PPKoller/ArgonCubeSlowControl/documents/ArgonCubeSlowControl_top_schematic.png

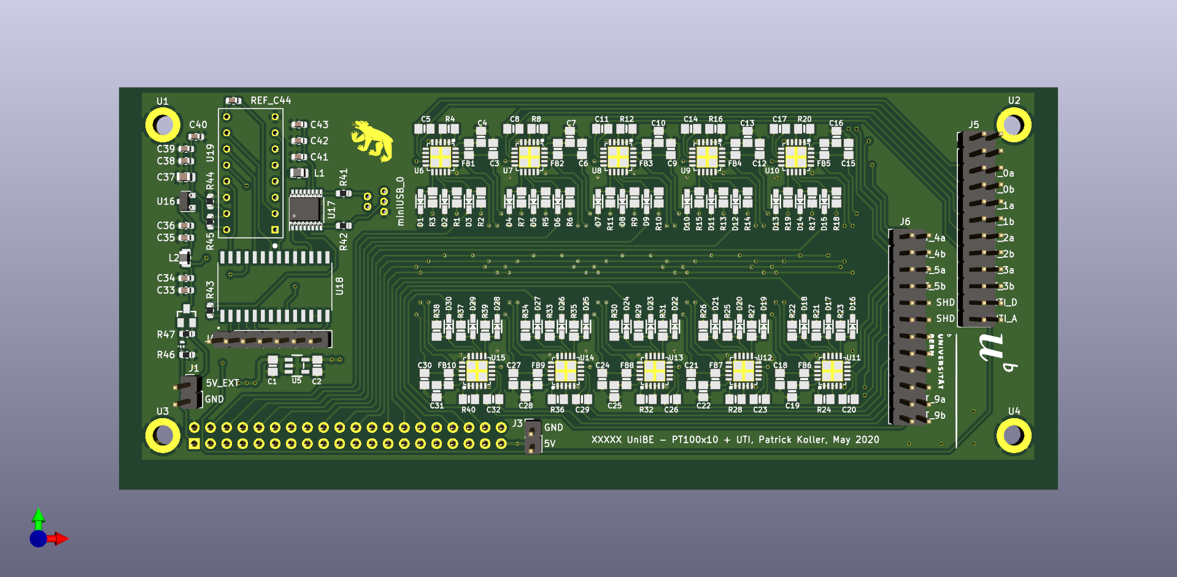
documents/ArgonCubeSlowControl_top_schematic.png
