PPKoller/ArgonCubeSlowControl/README.md

# ArgonCubeSlowControl
ArgonCube slow control PCB board.
