PPKoller/ArgonCubeSlowControl/documents/notes.txt

https://www.digikey.ch/product-detail/de/diodes-incorporated/DMN1150UFB-7B/DMN1150UFB-7BDITR-ND/3986748
https://www.digikey.ch/product-detail/de/on-semiconductor/NVTR0202PLT1G/NVTR0202PLT1GOSDKR-ND/9089349
