PPKoller/ArgonCubeSlowControl/documents/SlowControl_09032020.odp

## ArgonCube SC: PCB Design Front

UTI miniUSB

10x PT-100

UTI for lvl-meter

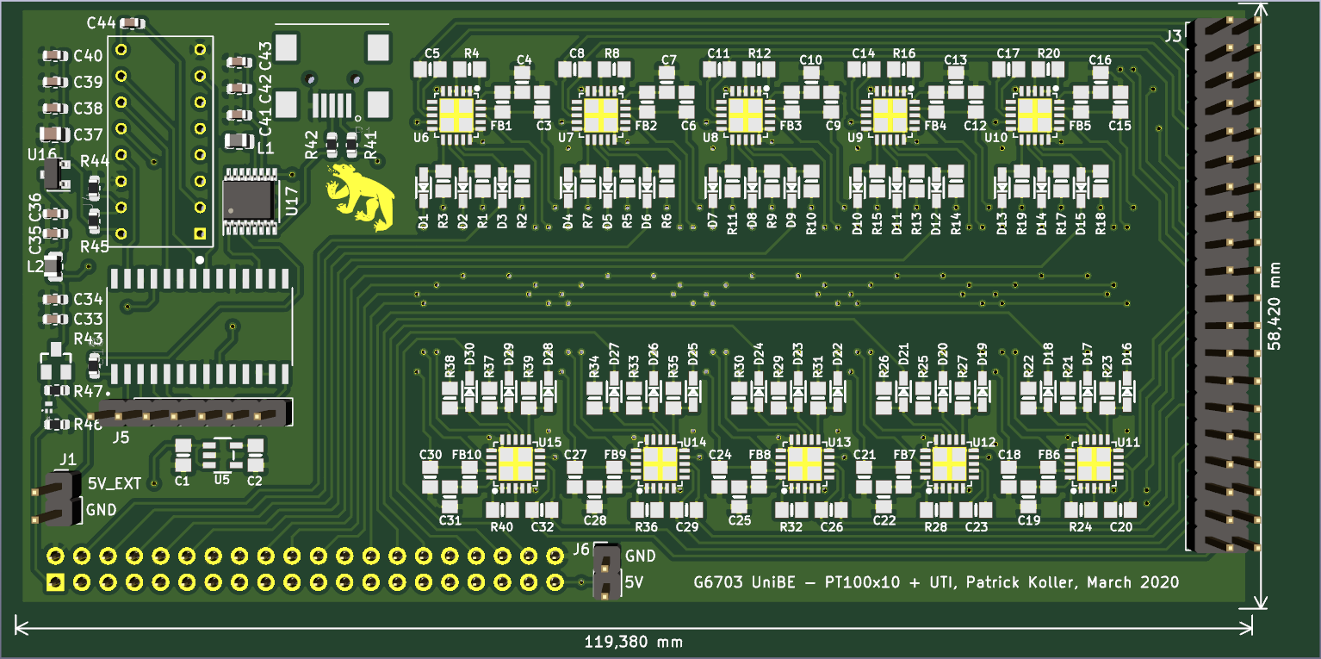
[picture p3: figure]

40-pin for

PT-100

UTI out

pins

5V_EXT

## ArgonCube SC: PCB Design Front

UTI for lvl-meter

MOSFET power switch for UTI

(needs testing!)

## ArgonCube SC: PCB Design Back

20-pin socket for RPi

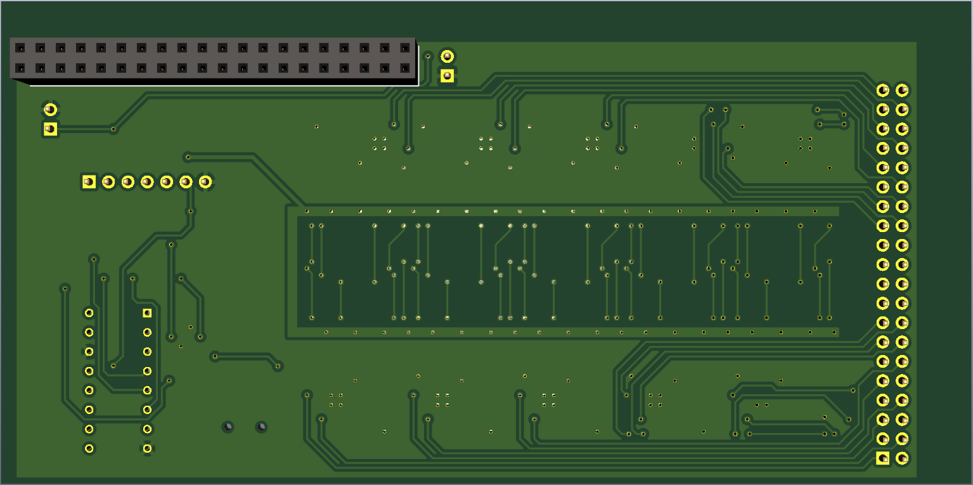
[picture p4: figure]

## ArgonCube SC: Raspberry Pi Mezzanine

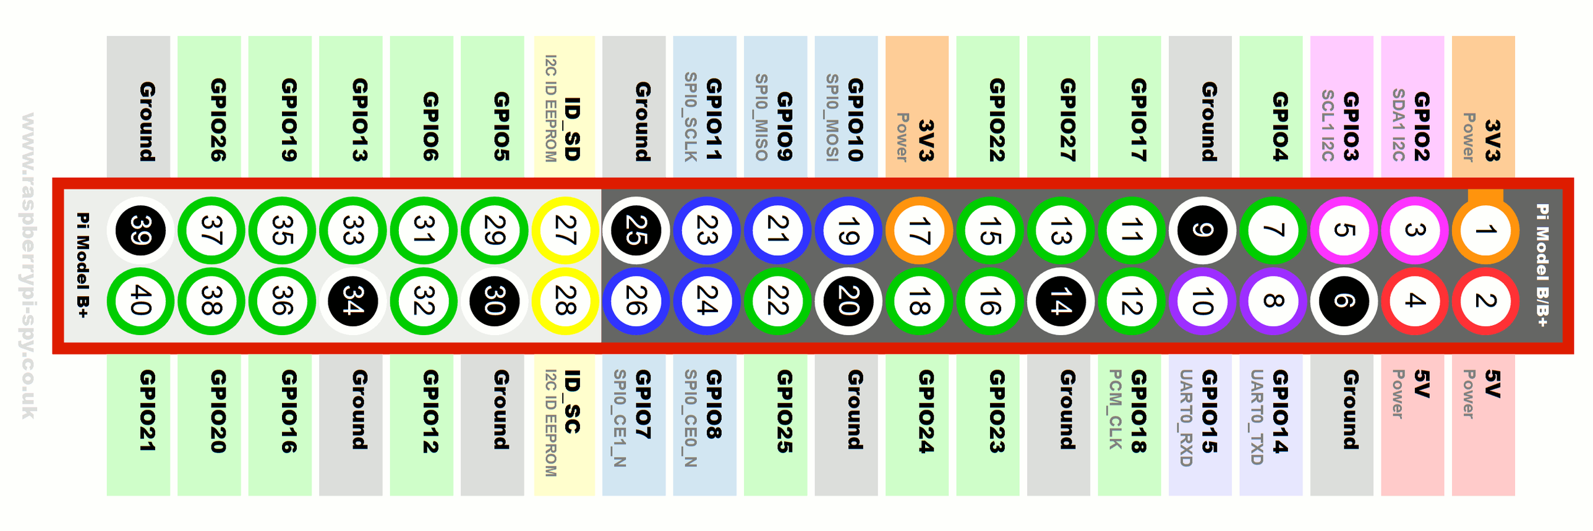
[picture p5: figure]
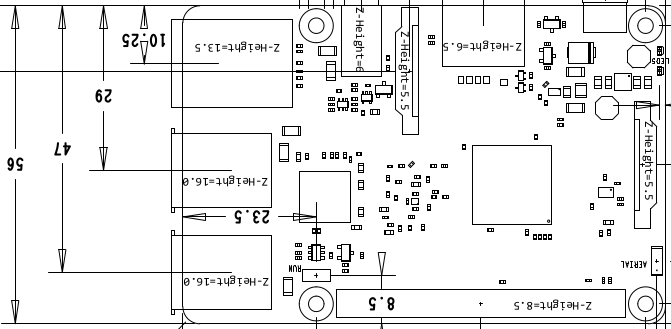
[picture p6: figure]

RPi 40-pin header

## ArgonCube SC: Raspberry Pi Mezzanine

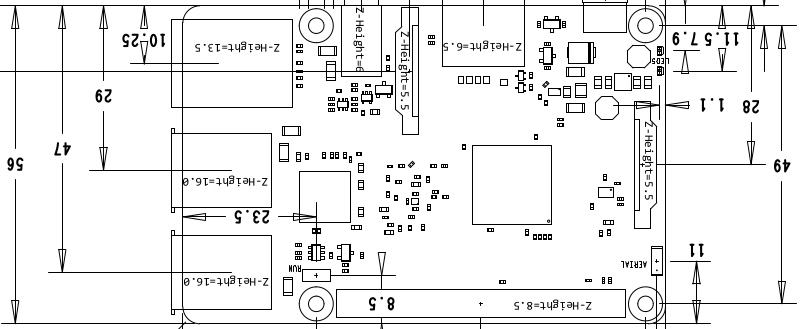
[picture p7: figure]
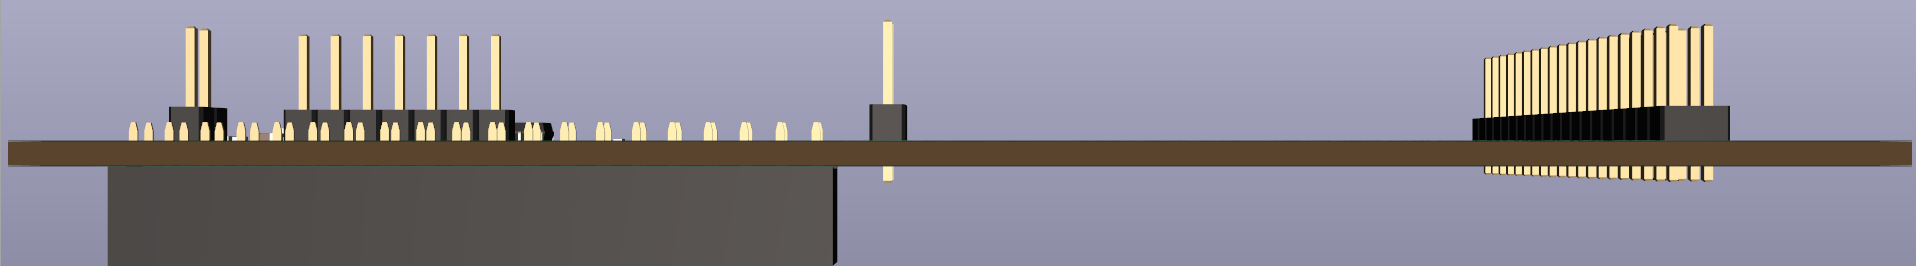
[picture p8: figure]

~ 15cm x 6cm

## ArgonCube SC: Raspberry Pi Mezzanine New

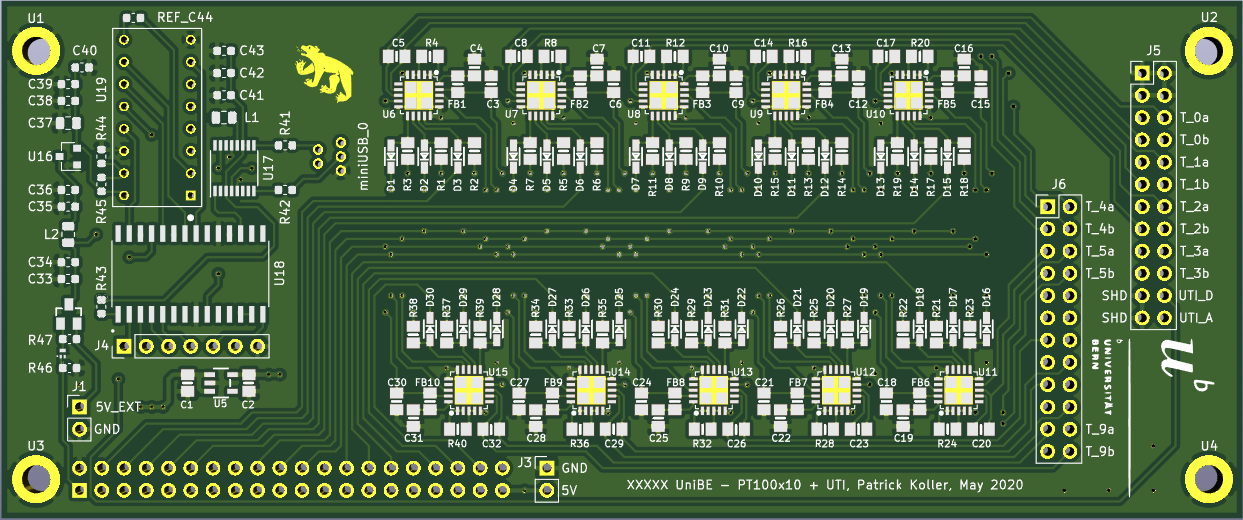
[picture p9: figure]

## ArgonCube SC: Questions

- Do you need specific connectors for the lvl-meter?
- Communication UTI ↔ RPi by miniUSB?
- Do the dimensions fit with a CF-60 flange?
