PPKoller/ArgonCubeSlowControl/documents/PCB_design_rules.pdf

## Design Rules

Abstand Rand: | 20mil
DuKo: | 28mil / 12mil

Leiterbahn: 10mil (min. 6)

Netz-Pad: | 10mil (min. 6)
Raster: | 5mil

Beschriftung:

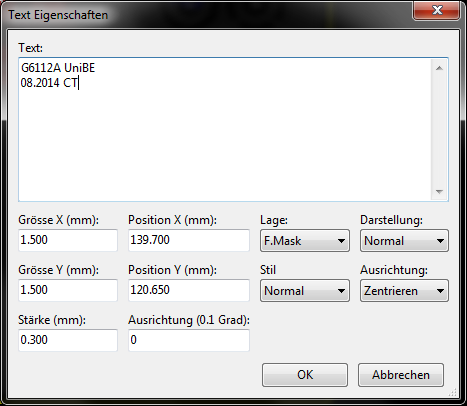
[picture p16: figure]

min Grösse 1.2mm / Stärke 0.3mm (Ausnahme 1.00)

MEG-ARRAY
| Pad | Via
TOP: | 25 | 28
SM TOP: 27
SP TOP: 23
BOT: | | 28
SM BOT: | | 30
IN: | | 28

DRILL: 12
