PPKoller/ArgonCubeSlowControl/documents/ArgonCubeSlowControl_btm.png

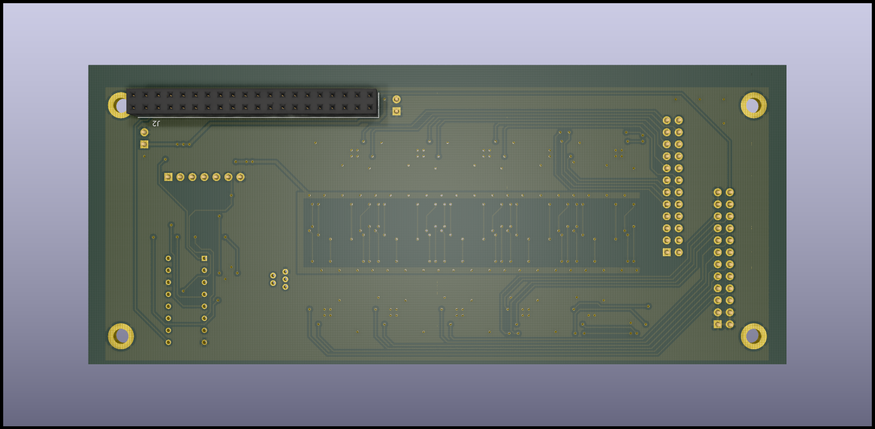
documents/ArgonCubeSlowControl_btm.png
