PPKoller/ArgonCubeSlowControl/documents/ArgonCubeSlowControl_btm_schematic.png

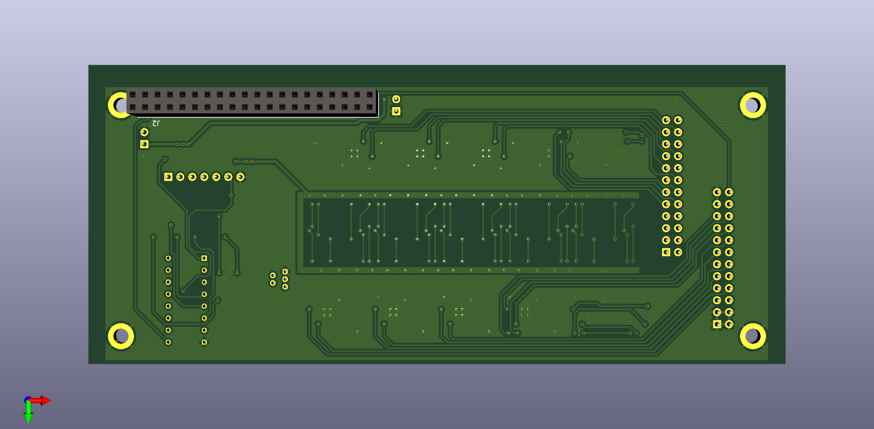
documents/ArgonCubeSlowControl_btm_schematic.png
