PPKoller/ArgonCubeSlowControl/documents/ArgonCubeSlowControl_tilt_btm.png

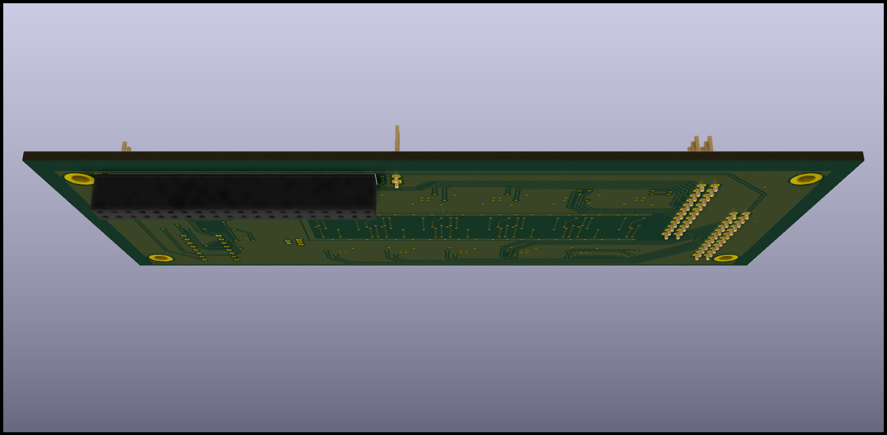
documents/ArgonCubeSlowControl_tilt_btm.png
