PPKoller/ArgonCubeSlowControl/documents/ArgonCubeSlowControl_tilt_top.png

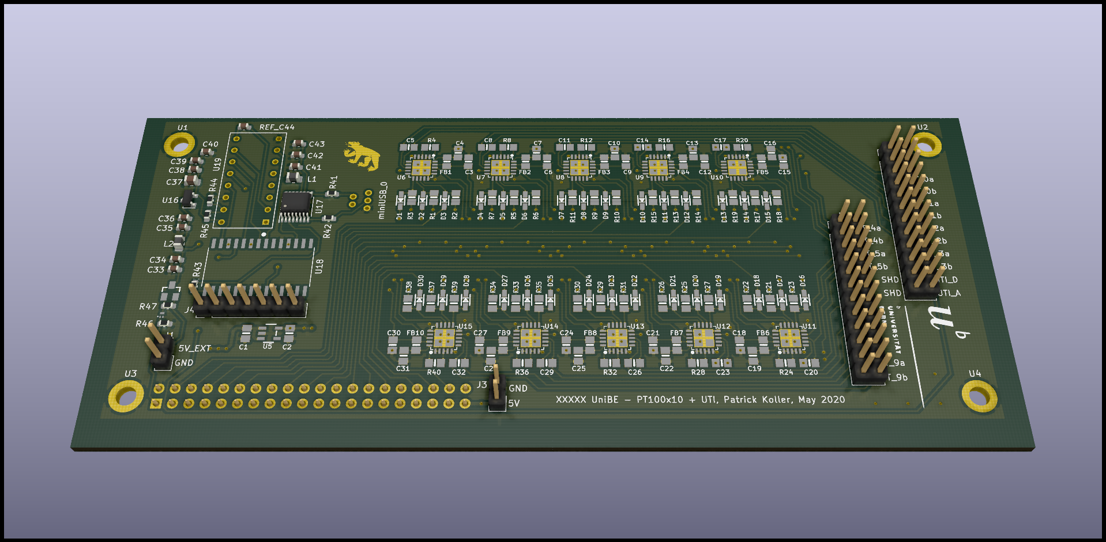
documents/ArgonCubeSlowControl_tilt_top.png
