PPKoller/ArgonCubeSlowControl/documents/IMG_20200917_114226.jpg

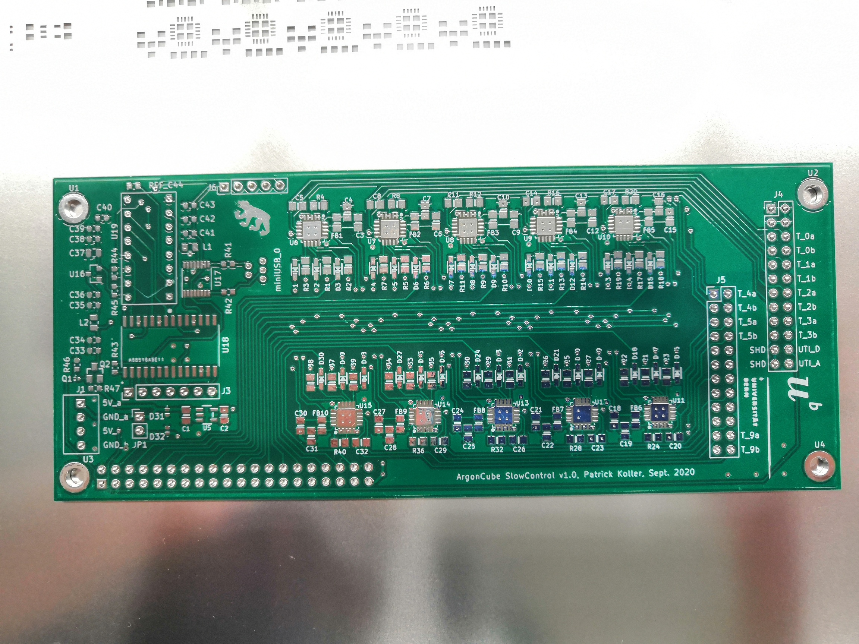
documents/IMG_20200917_114226.jpg
