PPKoller/ArgonCubeSlowControl/documents/pcb_pin-out.jpg

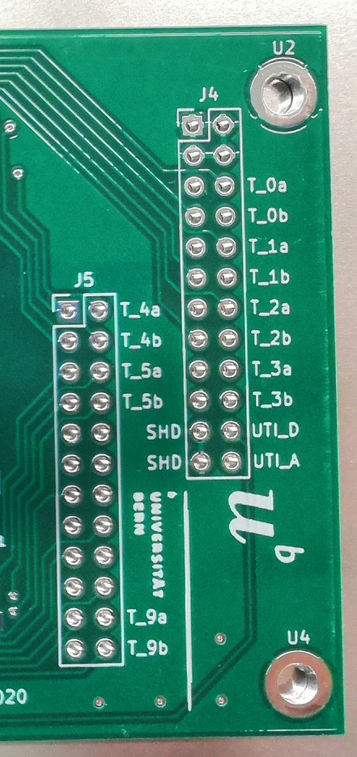
documents/pcb_pin-out.jpg
