PPKoller/ArgonCubeSlowControl/PCB/ArgonCubeSlowControl.step

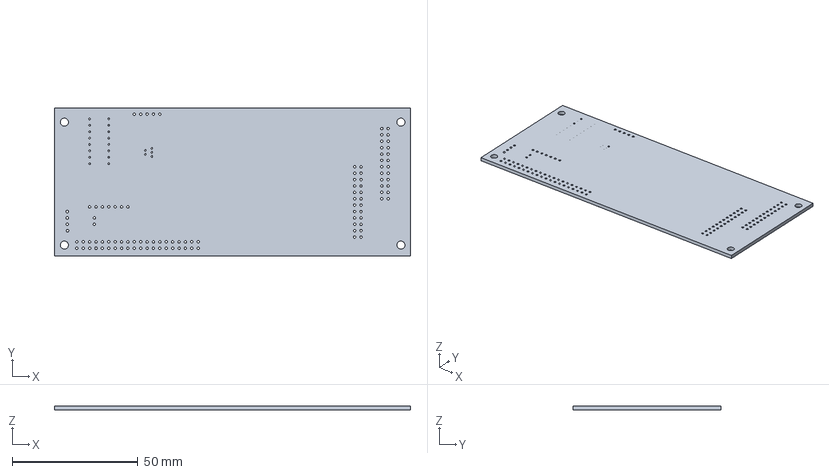
[picture p27: CAD file, 2020-09-03]
PCB/ArgonCubeSlowControl.step
141.6 x 59.1 x 1.60 mm
