PPKoller/ArgonCubeSlowControl/PCB/uti_3dmodels/4527--3DModel-STEP-56544.STEP

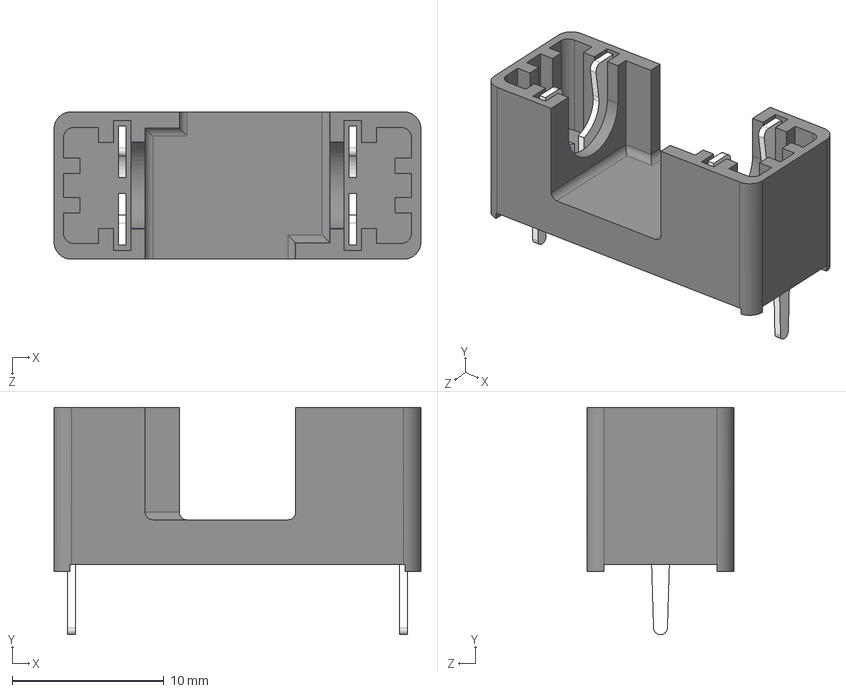
[picture p28: CAD file, 2020-05-07]
PCB/uti_3dmodels/4527--3DModel-STEP-56544.STEP
24.2 x 15.0 x 9.70 mm
