PPKoller/ArgonCubeSlowControl/(list of files, cad)

Other CAD files:
PCB/kicad-footprints/Sources/Package_SON/X2SON-4_1x1mm_P0.65mm.fcstd
PCB/kicad-footprints/Sources/Package_TO_SOT_THT/sod-70.fcstd
PCB/kicad-footprints/Sources/Package_TO_SOT_THT/sod-70_P5.08mm.fcstd
