PPKoller/ArgonCubeSlowControl/box/Feedthrough Metal range.pdf

# CLIFF

### Cliff Electronic Components Limited

76 Holmethorpe Avenue, Holmethorpe Ind. Estate,
Redhill, Surrey | 1 2 | U.K.RH | PF
Tel: +44 (0)1737 771375 Fax: +44 (0)1737 766012 | www.cliffuk.co.uk

¸RoHS

# METAL FEEDTHROUGH CONNECTORS FT Series

Part No. Description
CP30205NM USB 3.0 A to USB 3.0 A, Nickel Plated, CSK hole.

The FT Series of true feed through connectors are perfect for developing custom I/OMetal configurations for wall-plates, rack panels, etc. ALL fit within a standard XLR panel cutout, and use common cabling for front and back connections. No soldering, no punch terminations, just use the standard cable for that particular connector style. Mount from the front or back, low rear profile accommodates the tightest “behind the panel” spaces. Available in a wide variety of styles. These frames are made from diecast metal with a nickel finish.

Part No. Description
CP30200GM HDMI A Female to HDMI A, Gold Plated, CSK hole.
© CLIFF 06/18 Iss 9 | For further information, contact sales@cliffuk.co.uk
Part No. | Description
CP30204NM USB 3.0 B to USB 3.0 B, Nickel Plated, CSK hole.

Part No. Description
CP30203NM USB 2.0 B to USB 2.0 B, Nickel Plated, CSK hole.

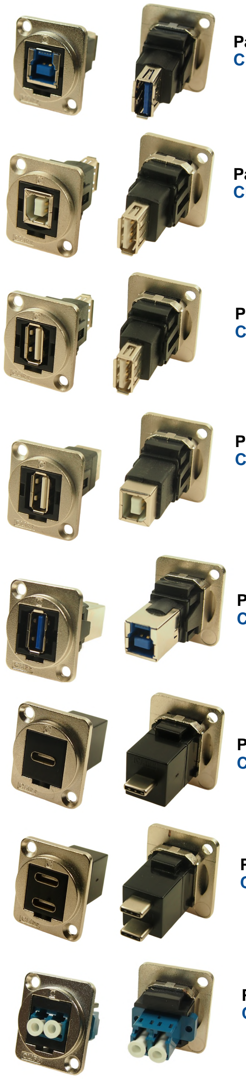
[picture p29: figure]

Part No. Description
CP30213M LC Duplex SM adaptor, Nickel Plated, CSK Hole

Part No. Description
CP30209NM USB 2.0 A to USB 2.0 B, Nickel Plated, CSK hole.

Part No. Description
CP30208NM USB 2.0 A to USB 2.0 A, Nickel Plated, CSK hole.

Part No. Description
CP30210NM USB 3.0 A to USB 3.0 B, Nickel Plated, CSK hole.

Part No. Description
CP30206NM USB 3.0 B to USB 3.0 A, Nickel Plated, CSK hole.

Part No. Description
CP30207NM USB 2.0 B to USB 2.0 A, Nickel Plated, CSK hole.

Part No. Description
CP30211M USB C Female to Male, Nickel Plated, CSK hole.

Part No. Description
CP30212M Dual USB C Female to Male, Nickel Plated, CSK hole.

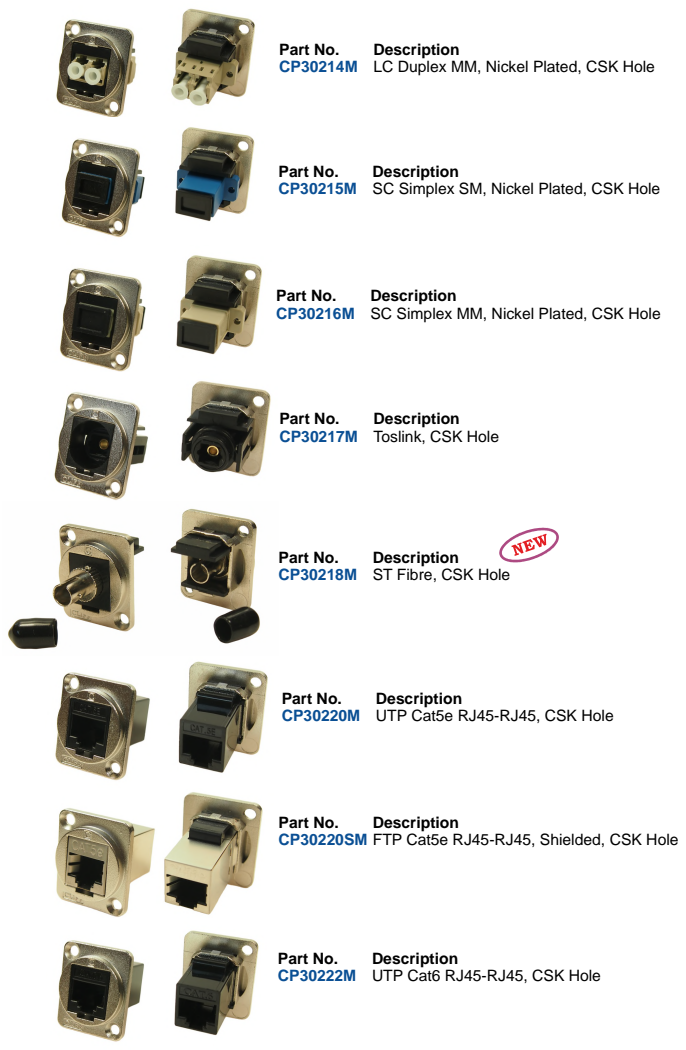
[picture p30: page 3]
Part No.; Description

CP30214M LC Duplex MM, Nickel Plated, CSK Hole

CP30215M SC Simplex SM, Nickel Plated, CSK Hole

CP30216M SC Simplex MM, Nickel Plated, CSK Hole

CP30217M Toslink, CSK Hole

CP30218M ST Fibre, CSK Hole

CP30220M UTP Cat5e RJ45-RJ45, CSK Hole

CP30220SM FTP Cat5e RJ45-RJ45, Shielded, CSK Hole

CP30222M UTP Cat6 RJ45-RJ45, CSK Hole

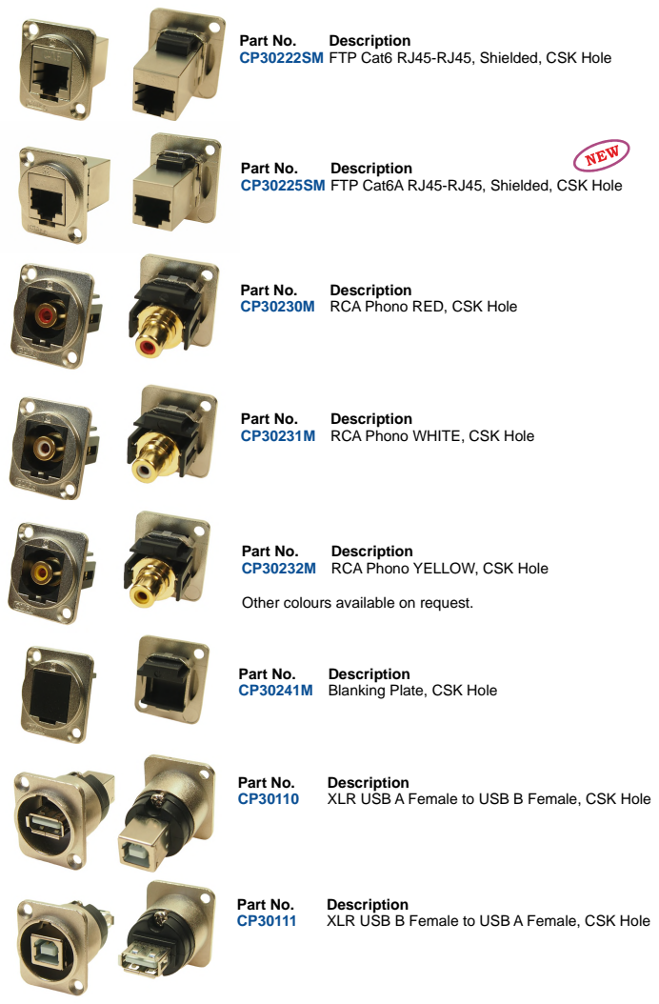
[picture p31: page 4]
Part No.; Description; XLR USB A Female to USB B Female, CSK Hole; XLR USB B Female to USB A Female, CSK Hole

CP30222SM FTP Cat6 RJ45-RJ45, Shielded, CSK Hole

CP30225SM FTP Cat6A RJ45-RJ45, Shielded, CSK Hole

CP30230M RCA Phono RED, CSK Hole

CP30231M RCA Phono WHITE, CSK Hole

CP30232M RCA Phono YELLOW, CSK Hole

Other colours available on request.

CP30241M Blanking Plate, CSK Hole

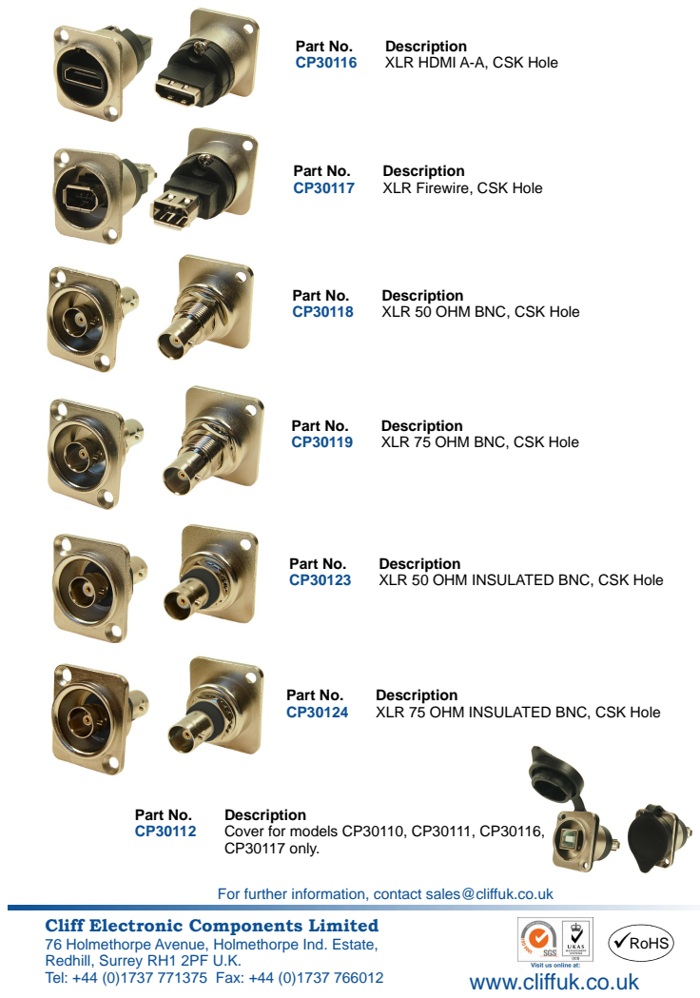
[picture p32: page 5]
Redhill, Surrey; Tel: +44 (0)1737 771375 Fax: +44 (0)1737 766012; www.cliffuk.co.uk; ¸RoHS; Part No.; Description; XLR 50 OHM BNC, CSK Hole; XLR 75 OHM BNC, CSK Hole; Cover for models C 30110, C 30111, C 30116,P; only.; XLR 50 OHM INSULATED BNC, CSK Hole; XLR 75 OHM INSULATED BNC, CSK Hole; XLR HDMI A-A, CSK Hole; XLR Firewire, CSK Hole

For further information, contact sales@cliffuk.co.uk

Cliff Electronic Components Limited
76 Holmethorpe Avenue, Holmethorpe Ind. Estate,
