PPKoller/ArgonCubeSlowControl/documents/SCbox_Power_Distrib.pdf

## PLC rack

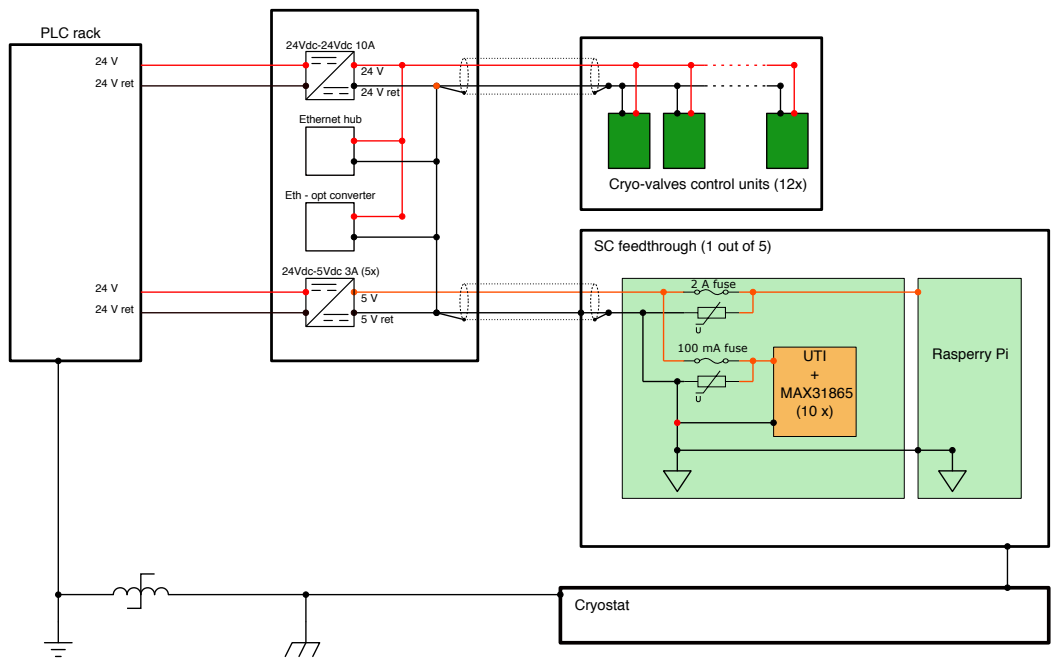
[picture p33: page 1]
24 V ret; 5 V ret; 24Vdc-24Vdc 10A; 24Vdc-5Vdc 3A (5x); Ethernet hub; UTI + MAX31865 (10 x); Rasperry Pi; Cryostat; 2 A fuse; 100 mA fuse

Cryo-valves control units (12x)

Eth - opt converter

SC feedthrough (1 out of 5)
