PPKoller/ArgonCubeSlowControl/box/marushin_MJ14SR-MJ15SR_eng_tds.pdf

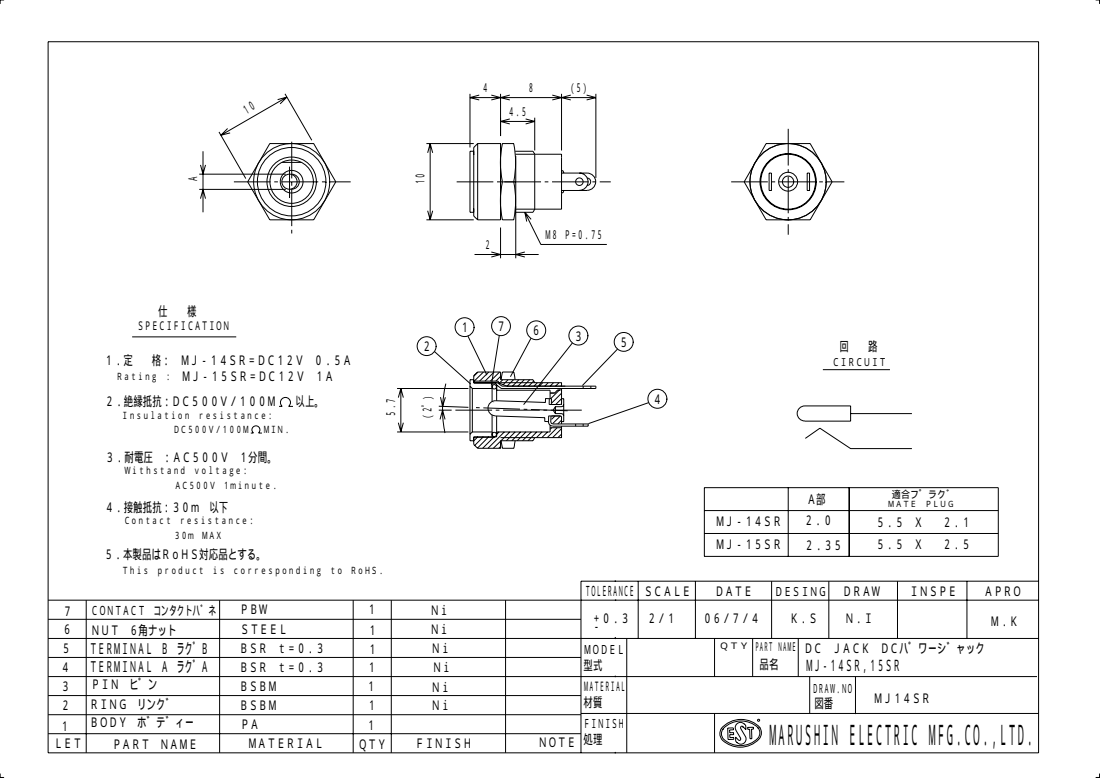
[picture p34: page 1]
ＣＯＮＴＡＣＴ コンタクトハ゛ネ; ＰＢＷ; ＣＩＲＣＵＩＴ; ２．絶縁抵抗：ＤＣ５００Ｖ／１００Ｍ 以上。; ３．耐電圧 ：ＡＣ５００Ｖ １分間。; ＳＰＥＣＩＦＩＣＡＴＩＯＮ; Ｒａｔｉｎｇ ：; Ｉｎｓｕｌａｔｉｏｎ ｒｅｓｉｓｔａｎｃｅ： ＤＣ５００Ｖ／１００Ｍ ＭＩＮ．; Ｗｉｔｈｓｔａｎｄ ｖｏｌｔａｇｅ：; ＡＣ５００Ｖ １ｍｉｎｕｔｅ．; 適合フ゜ラク゛; ４．接触抵抗：３０ｍΩ以下 Ｃｏｎｔａｃｔ ｒｅｓｉｓｔａｎｃｅ： ３０ｍΩＭＡＸ

Ａ部 | ＭＡＴＥ　ＰＬＵＧ

ＭＪ－１４ＳＲ | φ２．０ | φ５．５　Ｘ　φ２．１
ＭＪ－１５ＳＲ | φ２．３５ | φ５．５　Ｘ　φ２．５

５．本製品はＲｏＨＳ対応品とする。
Ｔｈｉｓ　ｐｒｏｄｕｃｔ　ｉｓ　ｃｏｒｒｅｓｐｏｎｄｉｎｇ　ｔｏ　ＲｏＨＳ．

ＴＯＬＥＲＡＮＣＥ | ＳＣＡＬＥ | ＤＡＴＥ ＤＥＳＩＮＧ ＤＲＡＷ ＩＮＳＰＥ | ＡＰＲＯ

６ | ＮＵＴ　６角ナット | ＳＴＥＥＬ | １ | Ｎｉ
５ | ＴＥＲＭＩＮＡＬ　Ｂ　ラク゛Ｂ | ＢＳＲ　ｔ＝０．３ | １ | Ｎｉ | | ＭＯＤＥＬ 型式 | ＤＣ　ＪＡＣＫ　ＤＣハ゜ワーシ゛ャック ＱＴＹ ＰＡＲＴ　ＮＡＭＥ 品名 ＭＪ－１４ＳＲ，１５ＳＲ
４ | ＴＥＲＭＩＮＡＬ　Ａ　ラク゛Ａ | ＢＳＲ　ｔ＝０．３ | １ | Ｎｉ
３ | ＰＩＮ　ヒ゜ン | ＢＳＢＭ | １ | Ｎｉ | | ＭＡＴＥＲＩＡＬ ＤＲＡＷ．ＮＯ 材質 ＭＪ１４ＳＲ 図番
２ | ＲＩＮＧ　リンク゛ | ＢＳＢＭ | １ | Ｎｉ
１ | ＢＯＤＹ　ホ゛テ゛ィー | ＰＡ | １ | | | ＦＩＮＩＳＨ ＭＡＲＵＳＨＩＮ　ＥＬＥＣＴＲＩＣ　ＭＦＧ．ＣＯ．，ＬＴＤ． 処理
ＬＥＴ | ＰＡＲＴ　ＮＡＭＥ | ＭＡＴＥＲＩＡＬ | ＱＴＹ | ＦＩＮＩＳＨ | ＮＯＴＥ
