PPKoller/ArgonCubeSlowControl/(commit log)

2020-02-25 Patrick: first commit.
    [ArgonCubeSlowControl.kicad_pcb, ArgonCubeSlowControl.sch, X2SON-4_1x1mm_P0.65mm.fcstd, max31865_00.sch, max31865_01.sch, max31865_02.sch, max31865_03.sch, max31865_04.sch]
2020-03-04 MOSFET switch, UTI circuit and documentation added.
    [PCB_design_requirements.ods, mosfet_switch.sch, uti.sch]
2020-03-07 Patrick: PT-100 area finished.
    [ArgonCubeSlowControl.kicad_pcb, max31865_00.sch, max31865_01.sch, max31865_02.sch, max31865_03.sch, max31865_04.sch, max31865_05.sch, max31865_06.sch]
2020-03-09 Patrick: First draft of final design.
    [ArgonCubeSlowControl.kicad_pcb]
2020-04-27 Patrick: added mounting holes and split header connector for sensors in two.
    [ArgonCubeSlowControl.kicad_pcb, ArgonCubeSlowControl.sch, PCB_design_requirements.ods, max31865_00.sch, max31865_01.sch, max31865_02.sch, max31865_03.sch, max31865_04.sch]
2020-04-27 Patrick: fixed two copper islands disconnected from GND.
    [ArgonCubeSlowControl.kicad_pcb]
2020-04-28 Patrick: metallized (GND) holes that match with RPi, vertical miniUSB moved inwards, labels GND->SHD for lvl meters, 0.5mm lanes for main VDD.
    [ArgonCubeSlowControl.kicad_pcb, ArgonCubeSlowControl.sch, max31865_00.sch, max31865_01.sch, max31865_02.sch, max31865_03.sch, max31865_04.sch, max31865_05.sch]
2020-05-07 Patrick: added place-holder for fuse.
    [4527--3DModel-STEP-56544.STEP, ArgonCubeSlowControl.kicad_pcb, power.sch, uti.sch]
2020-06-02 Patrick: final version without fuse.
    [ArgonCubeSlowControl.kicad_pcb, power.sch]
2020-06-02 Patrick: fixed wrong RPi-GND pin.
    [ArgonCubeSlowControl.kicad_pcb, power.sch]
2020-06-05 Patrick: fixed wrong labels on PCB, added documentation.
    [ArgonCubeSlowControl.kicad_pcb]
2020-07-21 Patrick: implemented fuses and bidirectional security diodes for powering lines.
    [ArgonCubeSlowControl.kicad_pcb, mosfet_switch.sch, power.sch, uti.sch]
2020-07-22 Patrick: added jumper to bridge the two individual external power lines, improved grounding.
    [ArgonCubeSlowControl.kicad_pcb, ArgonCubeSlowControl.sch, max31865_00.sch, max31865_01.sch, max31865_02.sch, max31865_03.sch, max31865_04.sch, max31865_05.sch]
2020-07-22 Patrick: Cosmetics.
    [ArgonCubeSlowControl.kicad_pcb, mosfet_switch.sch, power.sch, uti.sch]
2020-07-22 Patrick: made the 'Q2' silk label visible.
    [ArgonCubeSlowControl.kicad_pcb]
2020-07-22 Patrick: grounded floating pins and lvl meter SHD pins.
    [ArgonCubeSlowControl.kicad_pcb, ArgonCubeSlowControl.sch, max31865_00.sch, max31865_01.sch, max31865_02.sch, max31865_03.sch, max31865_04.sch, max31865_05.sch]
2020-07-23 Patrick: disconnected GND pin of the miniUSB connector from PCB GND.
    [ArgonCubeSlowControl.kicad_pcb, uti.sch]
2020-08-25 Patrick: removed fuses and added 5-pin header for PIC programming.
    [ArgonCubeSlowControl.kicad_pcb, power.sch, uti.sch]
2020-09-03 Patrick: fixed edge cuts, generated gerber drill-files and STEP file, ready for production.
    [ArgonCubeSlowControl.kicad_pcb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]
2020-09-03 Patrick: corrected name on PCB and added gerber drill-files.
    [ArgonCubeSlowControl-B.Cu.gbr, ArgonCubeSlowControl-B.Mask.gbr, ArgonCubeSlowControl-Edge.Cuts.gbr, ArgonCubeSlowControl-F.Cu.gbr, ArgonCubeSlowControl-F.Mask.gbr, ArgonCubeSlowControl-F.Paste.gbr, ArgonCubeSlowControl-F.SilkS.gbr, ArgonCubeSlowControl-NPTH.drl]
2020-10-02 Patrick: python script for raeading PT100 sensory with RPi.
    [ArgonCubeSlowControl_BOM.xls, ArgonCubeSlowControl_BOM.xlsm]
2020-10-13 Patrick: fixed wrong ground/source assignment of mosfet switch.
    [ArgonCubeSlowControl.kicad_pcb, mosfet_switch.sch]
2020-11-20 Patrick: custom calibrated straight line approximation.
